greenonline/currah_microspeech/kicad_6_files/README.md

KiCAD 6 files

Coming soon! End Sept 2026?
