greenonline/currah_microspeech/documentation/Currah µSpeech - routing.md

# Currah µSpeech - routing

## Preamble

The PCB is only a two layer, so one could either:

 - Remove all components and scan
 - Manually copy and redraw the traces in a PCB editor
