greenonline/currah_microspeech/documentation/Currah µSpeech - purchasing.md

# Currah µSpeech - purchasing

## Purchasing

 - [ZX Spectrum 48K Vintage Computer - briefcase, joystick and speech module, PSU](https://www.ebay.co.uk/itm/257696325083), £31 (auction) £43.02+£5.21 (click and collect £3.42?) total : £48.25 **<-- I got this!!!** £42.30+£3.42=£45.72
 - [Currah MicroSpeech ZX Spectrum Speech Sound Device Untested for Parts Or Repair](https://www.ebay.co.uk/itm/227477894410), £42.29+0 (£21.50 offer accepted) **<-- I got this!!!**
   - An earlier version of the PCB, with the "wrinkly" traces and R11, and no bodge resistor. Pin 12 of the SP0256 is cut and resoldered.
 - [Spectrum Sinclair Currah uSpeech Unit](https://www.ebay.co.uk/itm/298238237113), £37.10+£3.38
 - [Sinclair ZX Spectrum Currah Speech And Sound Cartridge Boxed Rare](https://www.ebay.co.uk/itm/800551556192), £32.94+£2.94
