greenonline/currah_microspeech/(commit log)

2026-08-29 Add documentation for Currah µSpeech reverse engineering
    Documented the reverse engineering process for the Currah µSpeech schematic and PCB layout, including component identification, sourcing, and pinout details.
2026-08-29 Add README.md for KiCAD 6 files
2026-08-29 Clarify photo references and PCB condition details
    Updated references to photos and clarified descriptions regarding R11 and the bodged resistor.
2026-09-08 Revise layout documentation with additional images
    Updated layout documentation with new images and notes on PCB traces.
2026-09-08 Clarify pin connections in documentation
    Updated pin references for clarity in documentation.
2026-09-08 Document board variants and their characteristics
    Added details about board variants for the PCB revisions, including differences in components and physical characteristics.
2026-09-09 Update pin configuration details in documentation
    Added pin configuration details for IOPut in the documentation.
2026-09-09 Revise pin descriptions and add input/output notes
    Updated pin configuration details and added notes on inputs and outputs.
2026-09-10 Fix typos and update pin output specifications
    Corrected typos and clarified pin configurations.
2026-09-10 Revise pin configuration details in documentation
    Updated pin configurations for the Currah µSpeech documentation, changing several pins from output to input and clarifying connections to the BUS and ROM.
2026-09-10 Update pin configuration details in documentation
2026-09-10 Clarify schematic derivation and add component details
    Updated the README to clarify the derivation of the schematic and added details about the components.
2026-09-10 Update instructions for Currah µSpeech ROM reading
    Clarified the process for reverse engineering a Currah µSpeech ROM using Arduino, including additional setup steps.
2026-09-11 Change pin 15 from input to output for /ROMCS
2026-09-11 Format resistor values for clarity in documentation
2026-09-11 Refactor ROM reading sketch for Arduino platforms
    Updated the ROM reading sketch for Arduino with improved platform handling and corrected function names.
2026-09-11 Update README with board bugs information
    Added a section on board bugs for early and later revisions.
2026-09-11 Update ROM reading documentation for clarity
    Clarified pin assignments for ROM chip select lines and corrected a typo.
2026-09-11 Update ROM reading documentation with contents
    Added detailed ROM contents and clarified CS1 pin configuration.
